natorator0011/RP2350A_dev_board/RP2350A_dev_board.kicad_pcb

## KiCad design RP2350A_dev_board.kicad_pcb (2026-03-05)

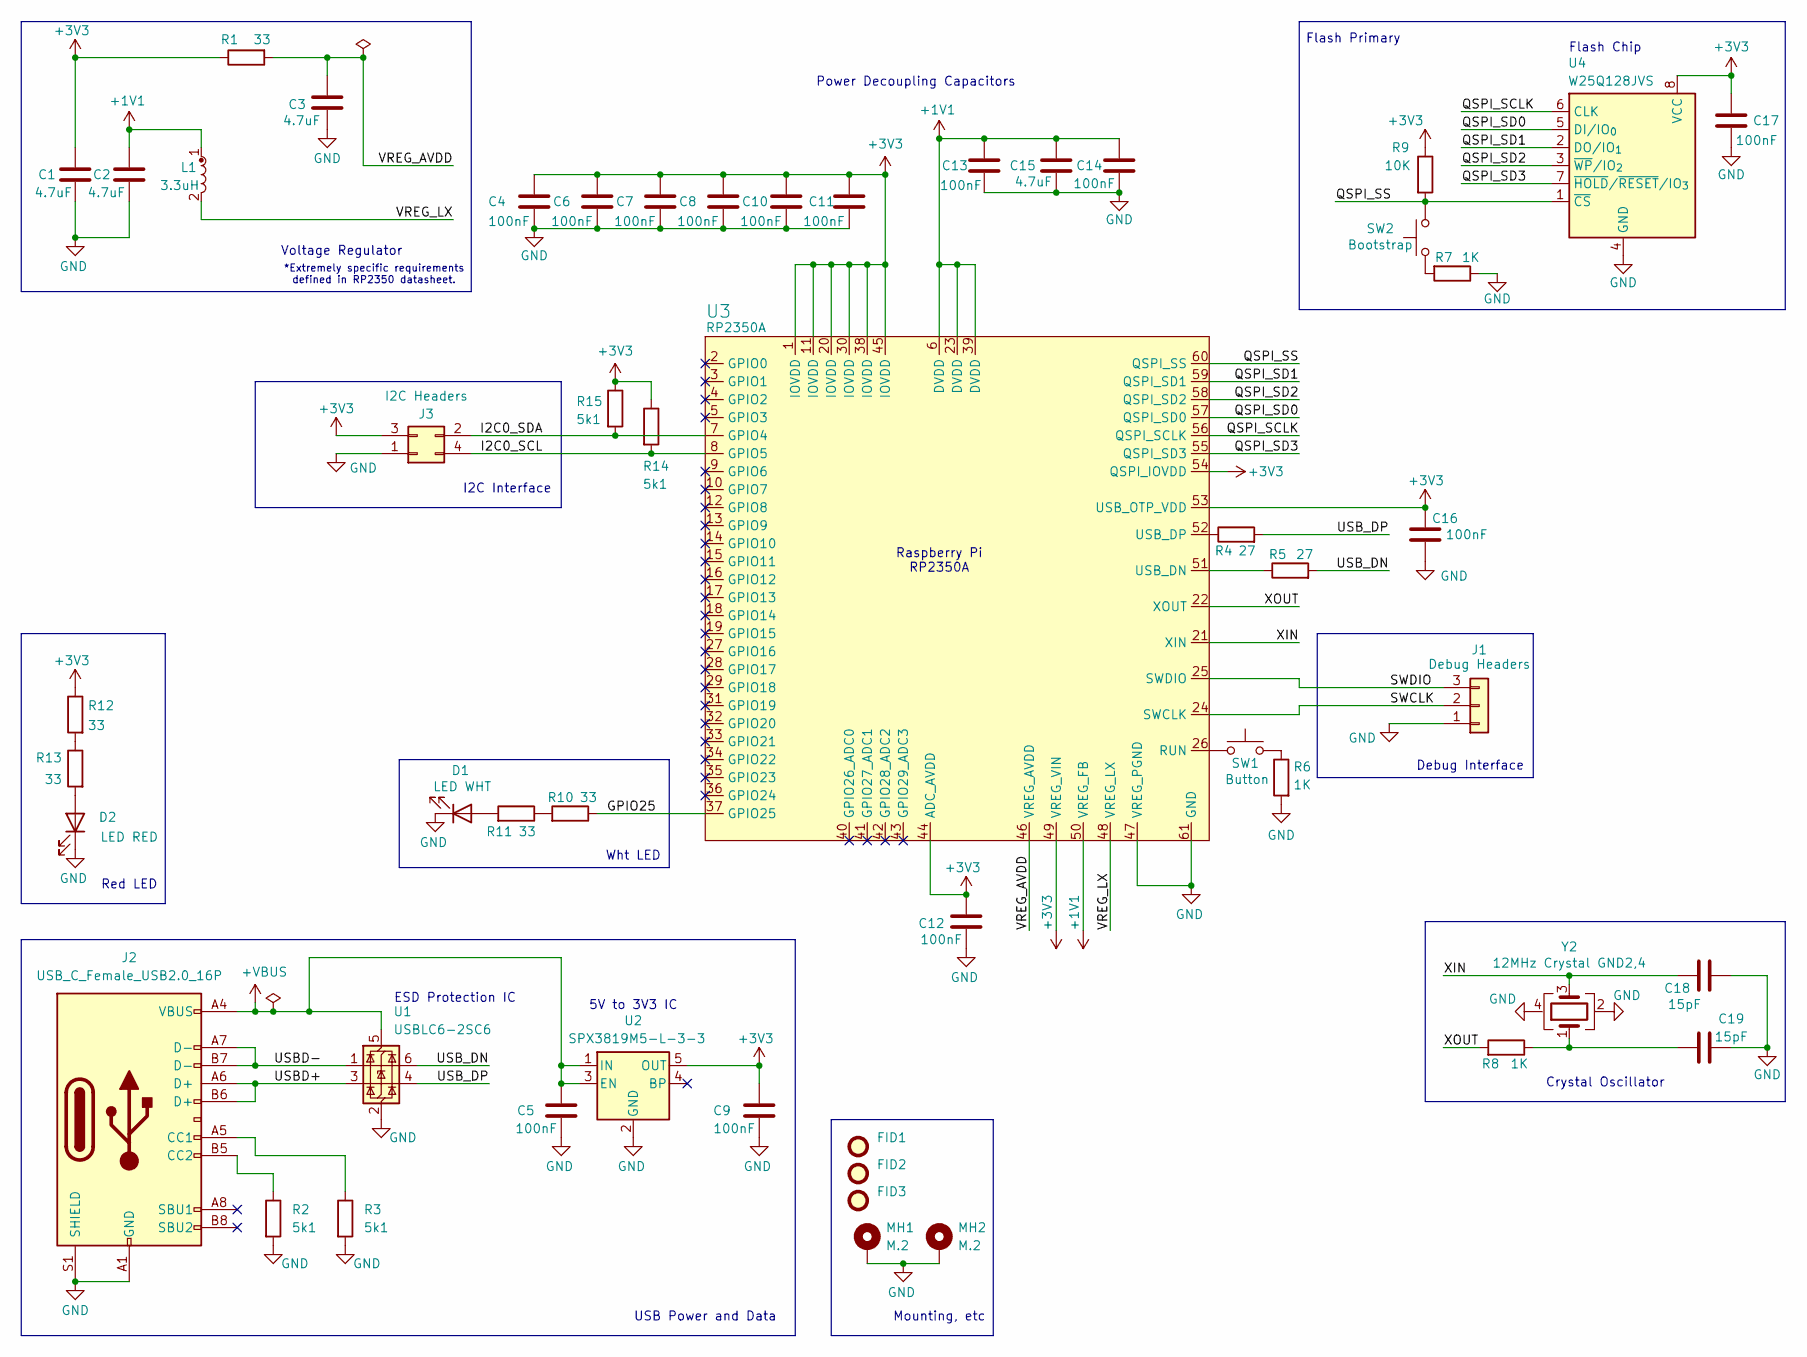
[picture p1: schematic RP2350A_dev_board.kicad_sch, RP2350A Breakout Board]

Parts:
C1, C2, C3, C15: 4.7uF; C_0603_1608Metric; Manufacturer Part Number CL10A475KO8NNNC; LCSC Part Number C19666
C4, C5, C6, C7, C8, C9, C10, C11, C12, C13, C14, C16, C17: 100nF; C_0603_1608Metric; Manufacturer Part Number CC0603KRX7R9BB104; LCSC Part Number C14663
C18, C19: 15pF; C_0603_1608Metric; Manufacturer Part Number CL10C150JB8NNNC; LCSC Part Number C1644
D1: LED WHT; LED_0603_1608Metric; Manufacturer Part Number KT-0603W; LCSC Part Number C2290
D2: LED RED; LED_0603_1608Metric; Manufacturer Part Number KT-0603R; LCSC Part Number C2286
FID1, FID2, FID3: Fiducial_1mm_Mask2mm
J1: Debug Headers; PinHeader_1x03_P2.54mm_Vertical
J2: USB_C_Female_USB2.0_16P; USB_C_Receptacle_GCT_USB4105-xx-A_16P_TopMnt_Horizontal; Manufacturer Part Number USB4105-GF-A-060; LCSC Part Number C3025063
J3: I2C Headers; PinHeader_2x02_P2.54mm_Vertical
L1: 3.3uH; AOTA-B201610S3R3-101-T_custom; Manufacturer Part Number AOTA-B201610S3R3-101-T; LCSC Part Number C42411119
MH1, MH2: M.2; MountingHole_2.2mm_M2_Pad_Via
R1, R10, R11, R12, R13: 33; R_0603_1608Metric; Manufacturer Part Number 0603WAF330JT5E; LCSC Part Number C23140
R2, R3, R14, R15: 5k1; R_0603_1608Metric; Manufacturer Part Number 0603WAF5101T5E; LCSC Part Number C23186
R4, R5: 27; R_0603_1608Metric; Manufacturer Part Number RCT0327RJLF; LCSC Part Number C177401
R6, R7, R8: 1K; R_0603_1608Metric; Manufacturer Part Number 0603WAF1001T5E; LCSC Part Number C21190
R9: 10K; R_0603_1608Metric; Manufacturer Part Number 0603WAF1002T5E; LCSC Part Number C25804
SW1: Button; SW_SPST_TS-1088-xR020; Manufacturer Part Number TS-1088-AR02016; LCSC Part Number C720477
SW2: Bootstrap; SW_SPST_TS-1088-xR020; Manufacturer Part Number TS-1088-AR02016; LCSC Part Number C720477
U1: USBLC6-2SC6; SOT-23-6; Manufacturer Part Number USBLC6-2SC6; LCSC Part Number C7519
U2: SPX3819M5-L-3-3; SOT-23-5; Manufacturer Part Number SPX3819M5-L-3-3; LCSC Part Number C20617301
U3: RP2350A; QFN-60-1EP_7x7mm_P0.4mm_EP3.4x3.4mm; Manufacturer Part Number RP2350A; LCSC Part Number C42411118
U4: W25Q128JVS; SOIC-8_5.3x5.3mm_P1.27mm; Manufacturer Part Number W25Q128JVSIQ; LCSC Part Number C97521
Y2: 12MHz Crystal GND2,4; ABM8-272-T3; Manufacturer Part Number ABM8-272-T3; LCSC Part Number C20625731

Connections:
+1V1: C2.1, C13.1, C14.1, C15.1, L1.1, U3.6 (DVDD), U3.23 (DVDD), U3.39 (DVDD), U3.50 (VREG_FB)
+3V3: C1.2, C4.1, C6.1, C7.1, C8.1, C9.1, C10.1, C11.1, C12.1, C16.2, C17.1, J3.3, R1.1, R9.1, R12.1, R14.1, R15.1, U2.5 (OUT), U3.1 (IOVDD), U3.11 (IOVDD), U3.20 (IOVDD), U3.30 (IOVDD), U3.38 (IOVDD), U3.44 (ADC_AVDD), U3.45 (IOVDD), U3.49 (VREG_VIN), U3.53 (USB_OTP_VDD), U3.54 (QSPI_IOVDD), U4.8 (VCC)
+VBUS: C5.1, J2.A4 (VBUS), J2.A9 (VBUS), J2.B4 (VBUS), J2.B9 (VBUS), U1.5 (VBUS), U2.1 (IN), U2.3 (EN)
/GPIO25: R10.1, U3.37 (GPIO25)
/I2C0_SCL: J3.4 (Pin_2), R14.2, U3.8 (GPIO5)
/I2C0_SDA: J3.2 (Pin_4), R15.2, U3.7 (GPIO4)
/QSPI_SCLK: U3.56 (QSPI_SCLK), U4.6 (CLK)
/QSPI_SD0: U3.57 (QSPI_SD0), U4.5 (DI/IO_{0})
/QSPI_SD1: U3.59 (QSPI_SD1), U4.2 (DO/IO_{1})
/QSPI_SD2: U3.58 (QSPI_SD2), U4.3 (~WP/IO_{2})
/QSPI_SD3: U3.55 (QSPI_SD3), U4.7 (~HOLD/~RESET/IO_{3})
/QSPI_SS: R9.2, SW2.2, U3.60 (QSPI_SS), U4.1 (~CS)
/SWCLK: J1.2, U3.24 (SWCLK)
/SWDIO: J1.3, U3.25 (SWDIO)
/USBD+: J2.A6 (D+), J2.B6 (D+), U1.3 (I/O2)
/USBD-: J2.A7 (D-), J2.B7 (D-), U1.1 (I/O1)
/USB_DN: R5.2, U1.6 (I/O1)
/USB_DP: R4.2, U1.4 (I/O2)
/VREG_AVDD: C3.2, R1.2, U3.46 (VREG_AVDD)
/VREG_LX: L1.2, U3.48 (VREG_LX)
/XIN: C18.2, U3.21 (XIN), Y2.3
/XOUT: R8.2, U3.22 (XOUT)
GND: C1.1, C2.2, C3.1, C4.2, C5.2, C6.2, C7.2, C8.2, C9.2, C10.2, C11.2, C12.2, C13.2, C14.2, C15.2, C16.1, C17.2, C18.1, C19.1, D1.1 (K), D2.1 (K), J1.1, J2.A1 (GND), J2.A12 (GND), J2.B1 (GND), J2.B12 (GND), J2.S1 (SHIELD), J3.1, MH1.1, MH2.1, R2.2, R3.2, R6.2, R7.1, U1.2 (GND), U2.2 (GND), U3.47 (VREG_PGND), U3.61 (GND), U4.4 (GND), Y2.2 (G), Y2.4 (G)
unnamed: C19.2, R8.1, Y2.1
unnamed: D1.2 (A), R11.2
unnamed: D2.2 (A), R13.2
unnamed: J2.A5 (CC1), R3.1
unnamed: J2.B5 (CC2), R2.1
unnamed: R6.1, SW1.2
unnamed: R7.2, SW2.1
unnamed: R10.2, R11.1
unnamed: R12.2, R13.1
unnamed: SW1.1, U3.26 (RUN)
unnamed: R5.1, U3.51 (USB_DN)
unnamed: R4.1, U3.52 (USB_DP)

Notes on the sheet:
5V to 3V3 IC
I2C Interface
Debug Interface
Raspberry Pi RP2350A
Mounting, etc
*Extremely specific requirements defined in RP2350 datasheet.
ESD Protection IC
Power Decoupling Capacitors
Flash Primary
Flash Chip
Red LED
USB Power and Data
Wht LED
Voltage Regulator
Crystal Oscillator

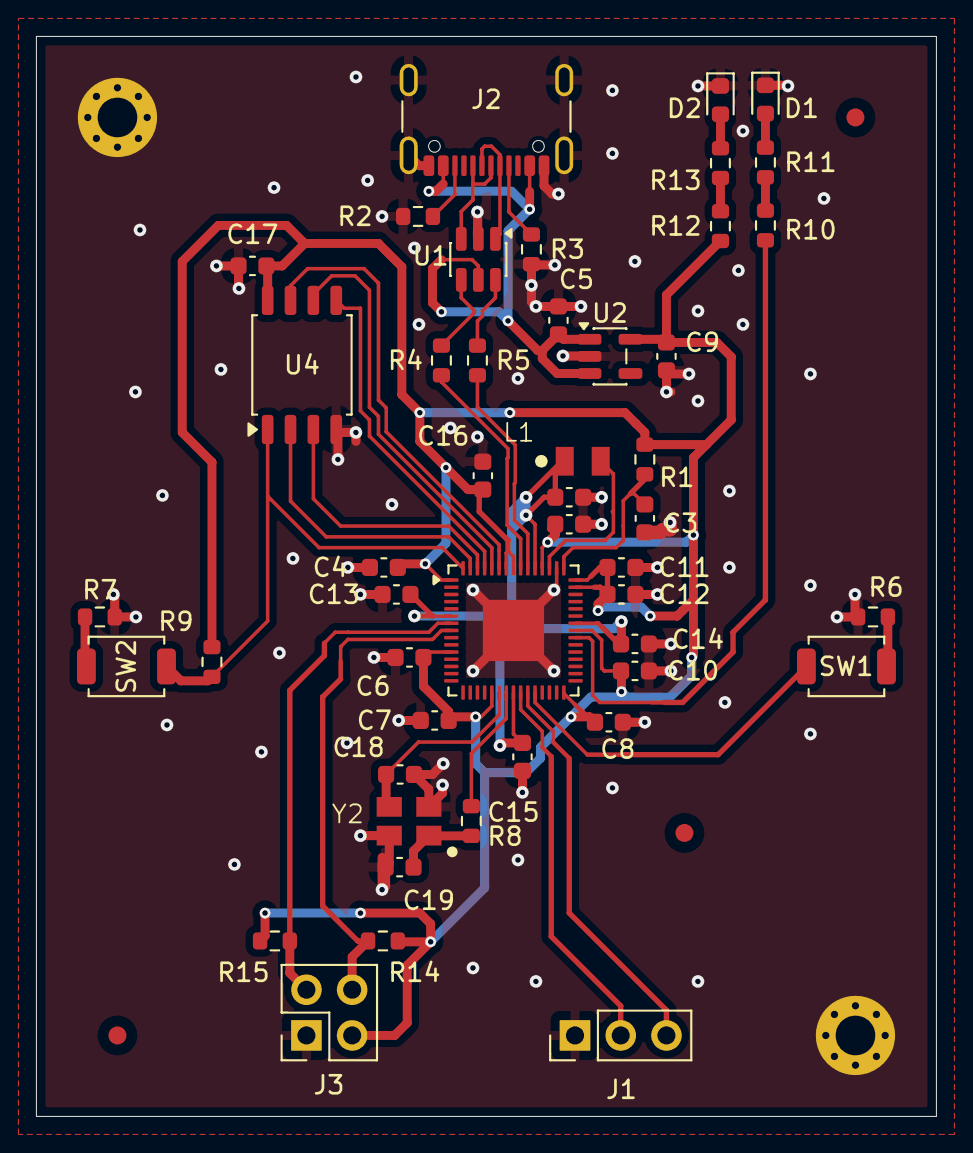
[picture p2: board RP2350A_dev_board.kicad_pcb from above]

Board: 2 copper layers, 50.0 x 60.0 mm, 52 parts (0 on the bottom side), 35 nets.
