natorator0011/RP2350A_dev_board/(commit log)

2026-02-19 Added Red LED, Wht LED modules. Houskeeping.
    [RP2350A_dev_board.kicad_pcb, RP2350A_dev_board.kicad_sch]
2026-02-19 Added I2C Interface, Debug Interface.
    [RP2350A_dev_board.kicad_sch]
2026-02-20 Added and configured additional net classes. Began ERC fixes.
    [RP2350A_dev_board.kicad_sch]
2026-02-20 Fixed all ERC issues.
    [RP2350A_dev_board.kicad_sch]
2026-02-20 Reorganized for readability.
    [RP2350A_dev_board.kicad_sch]
2026-02-20 Reorganized again.
    [RP2350A_dev_board.kicad_sch]
2026-02-21 Began PCB Layout. reorganized DVDD decoupling capacitors for readability. Fixed L1 inductor footprint, Y2 Crystal footprint.
    [RP2350A_dev_board.kicad_pcb, RP2350A_dev_board.kicad_sch]
2026-02-21 Finished rough layout. Incorporated 5.1K pull-up resistors for I2C lines.
    [RP2350A_dev_board.kicad_pcb, RP2350A_dev_board.kicad_sch]
2026-02-21 Modified PCB layout, added GND plane on layer 2, began adding GND vias.
    [RP2350A_dev_board.kicad_pcb]
2026-02-22 Added vias to Voltage Regulator.
    [RP2350A_dev_board.kicad_pcb]
2026-02-25 Fixed via and ground plane interractions. Added +1V1 and +3V3 planes.
    [RP2350A_dev_board.kicad_pcb]
2026-02-26 Replaced +1V1 and +3V3 planes with wide routes. Routed all power. Finished all routing.
    [RP2350A_dev_board.kicad_pcb, RP2350A_dev_board.kicad_sch]
2026-02-27 Finished routing. Cleared ERC on schematic and layout.
    [RP2350A_dev_board.kicad_pcb, RP2350A_dev_board.kicad_sch]
2026-03-05 Final commit for time being, getting board printed and assembled was outside my price range. Unfortunately, oldering 0604 components is also outside my skill range. Project needs to be reorganized us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
    [RP2350A_dev_board.kicad_pcb, RP2350A_dev_board.kicad_sch]
